akita11/SolenoidController/README.md

# SolenoidController

・ソレノイドやDCモータを4個、制御できるボード。単体でスイッチでON/OFFできる。
・各種マイコン(Arduino, micro:bit, RaspberryPi, IchigoJam, Grove)からも制御できる。
・電源は24Vまで（使用するソレノイドにあわせる）
- オプションで、USB Type-C PDからの給電もできる（検証は不十分）

# Author

Junichi Akita (@akita11, akita@ifdl.jp)
