akita11/SolenoidController/SoneloidController_,man.pdf

## SoneloidControllerの使い方

@akita11

## ボードの概要・定格

- 最大４個のソレノイドを、ボード上のスイッチ、
マイコンから制御できる
- 電源はACアダプタ、電池等（microUSBも可）
- 電源電圧の最大値＝24V

## 各部の名称・機能

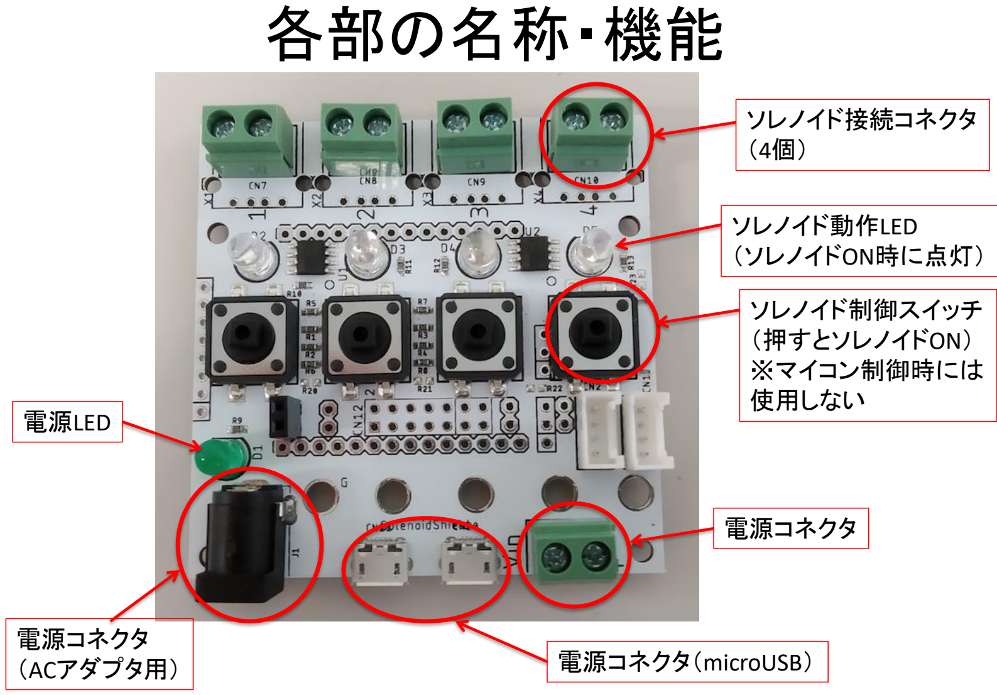
[picture p1: page 3]

ソレノイド接続コネクタ
（4個）

ソレノイド動作LED
（ソレノイドON時に点灯）

ソレノイド制御スイッチ
（押すとソレノイドON）
※マイコン制御時には
使用しない

電源コネクタ

電源コネクタ（microUSB）

電源LED

電源コネクタ
（ACアダプタ用）

## 電源の接続

- 以下のいずれかの電源を接続する
– ACアダプタ（φ2.1mm・センター＋）
– 電池ボックス等からの＋・ーのケーブル
– モバイルバッテリ等（microUSBケーブル経由） （原則として片方のコネクタのみ用いる）
- 電圧は用いるソレノイドにあわせる
- いずれか1つのみ接続する

### 緑色の端子に接続する場合の注意

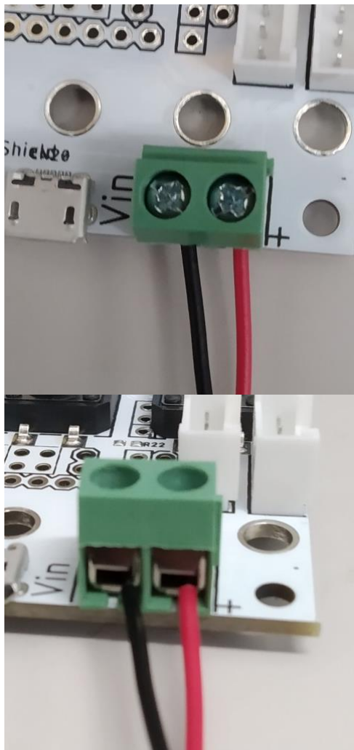
[picture p2: figure]

- ＋・－を間違えないように注意
する
※ソレノイド単体と異なり、逆接
続すると本ボードが故障します
- 端子からあまり導線の芯線が
出ないように注意（隣とショート
する危険がある）
- はずれやすい場合は棒端子を
用いるとよい

## 使用可能な電源の例

- 使用可能なACアダプタの例
– http://akizukidenshi.com/catalog/g/gM-06239/（12V・2A）
- 使用可能な電池ボックスの例

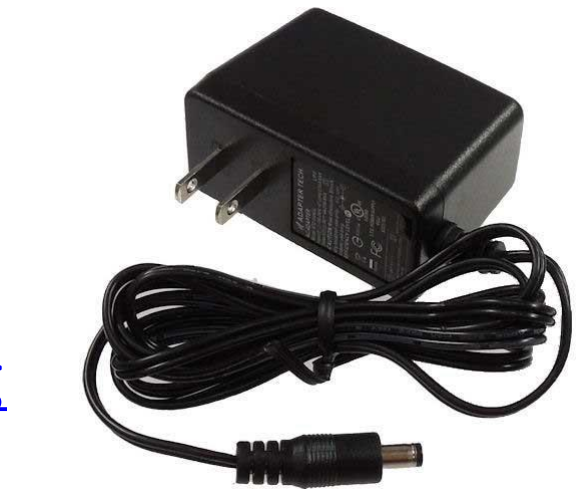
[picture p3: figure]

– http://akizukidenshi.com/catalog/g/gP-10612/

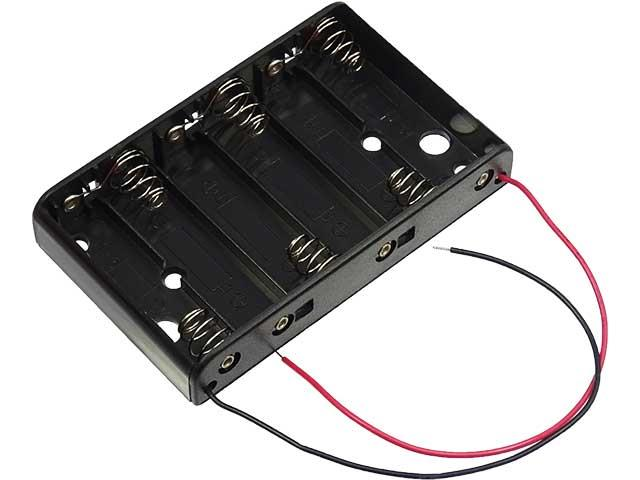
[picture p4: figure]

## ソレノイドの接続

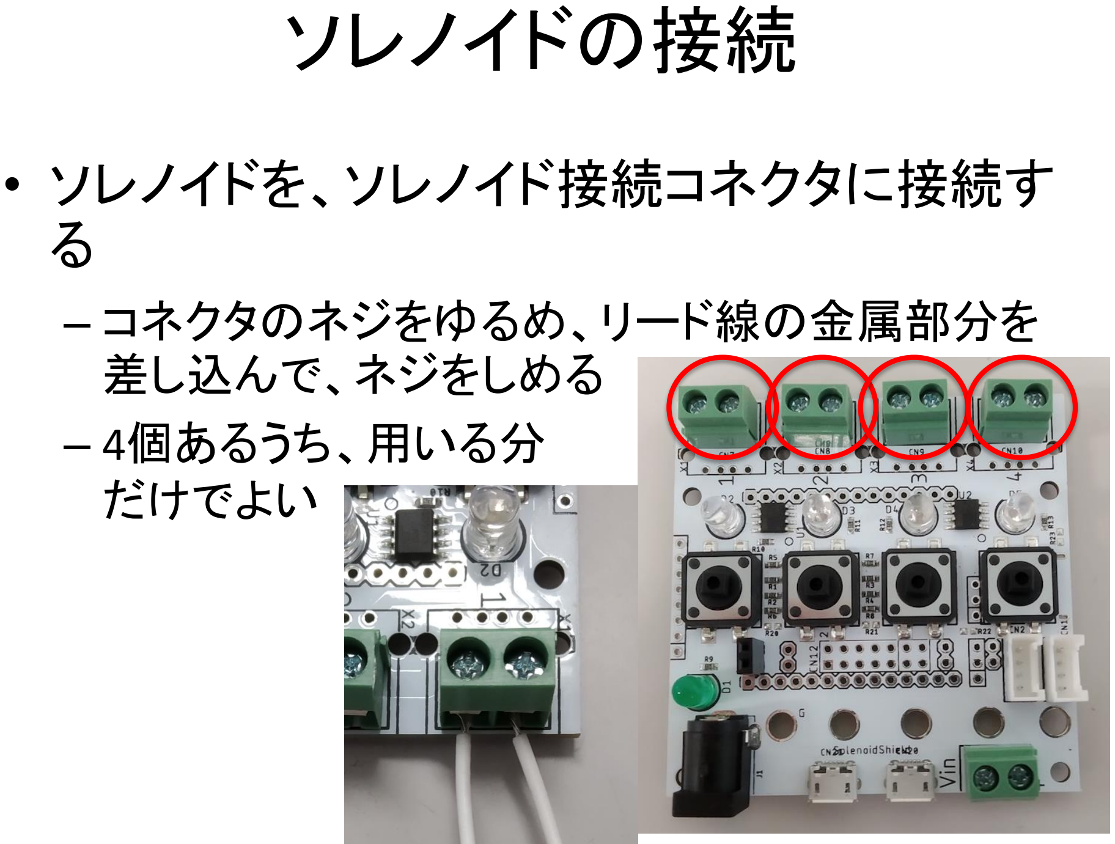
[picture p5: page 7]

- ソレノイドを、ソレノイド接続コネクタに接続す
る
– コネクタのネジをゆるめ、リード線の金属部分を
差し込んで、ネジをしめる
– 4個あるうち、用いる分
だけでよい

## 基本的な使い方

- 電源とソレノイドを接続後、スイッチを押すと、
対応するソレノイドがONになる

## Arduinoとの接続（１）

- ピンヘッダをとりつける（2p, 8p）

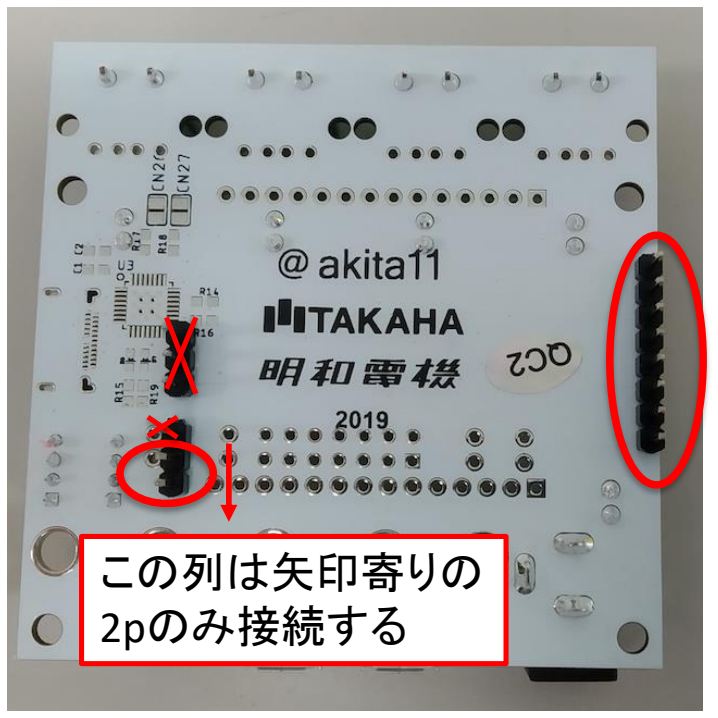
[picture p6: figure]
この列は矢印寄りの 2pのみ接続する

## Arduinoとの接続（２）

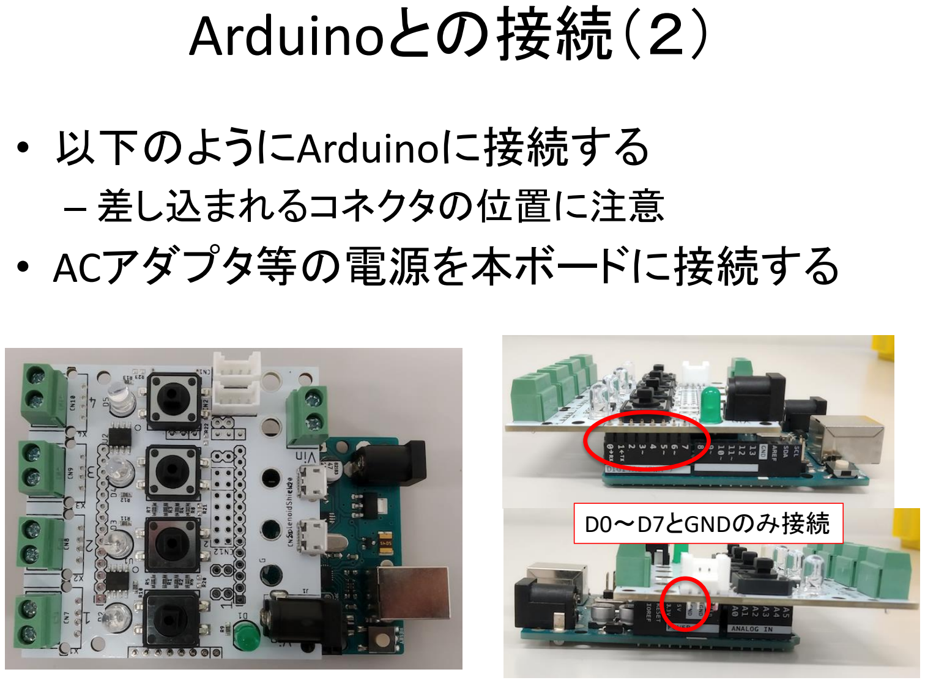
[picture p7: page 10]

- 以下のようにArduinoに接続する
– 差し込まれるコネクタの位置に注意
- ACアダプタ等の電源を本ボードに接続する

D0～D7とGNDのみ接続

## Arduinoとの接続（３）

- ArduinoのD2～D5が、ソレノイド#1～#4に対 応
- D2～D5をDigitalOutに設定
– 1(HIGH)=ON
– 0(LOW)=OFF

## micro:bitとの接続（１）

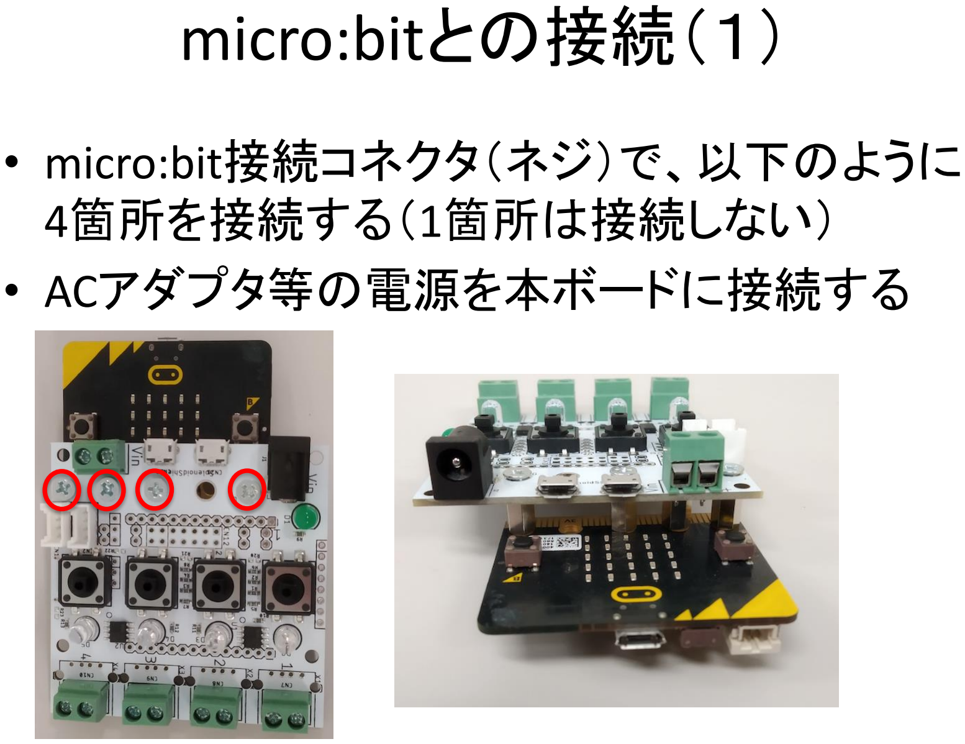
[picture p8: page 12]

- micro:bit接続コネクタ（ネジ）で、以下のように 4箇所を接続する（1箇所は接続しない）
- ACアダプタ等の電源を本ボードに接続する

## micro:bitとの接続（２）

- micro:bitのIOピンP0～2が、ソレノイド#1～#3 に対応
– ソレノイド#4は制御できない
- IOピン1～2を出力に設定
– 1(HIGH)=ON
– 0(LOW)=OFF

## Groveとの接続（１）

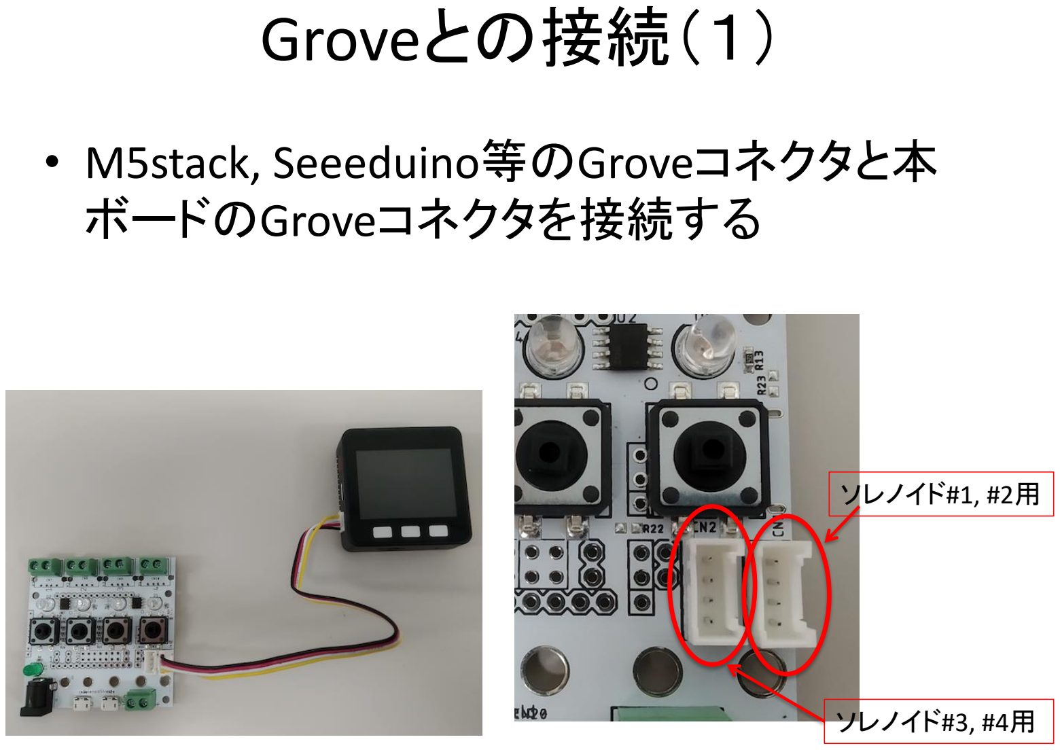
[picture p9: page 14]

- M5stack, Seeeduino等のGroveコネクタと本 ボードのGroveコネクタを接続する

ソレノイド#1, #2用

ソレノイド#3, #4用

## Groveとの接続（２）

- ソレノイド#1,#2用コネクタ
– GroveのディジタルIOの1番、2番に対応
– DigitalOutの1(HIGH)=On, 0(LOW)=Off
- ソレノイド#3,#4用コネクタ
– GroveのディジタルIOの1番、2番に対応
– DigitalOutの1(HIGH)=On, 0(LOW)=Off

## IchigoJamとの接続（１）

- ピンヘッダをとりつける（6p）

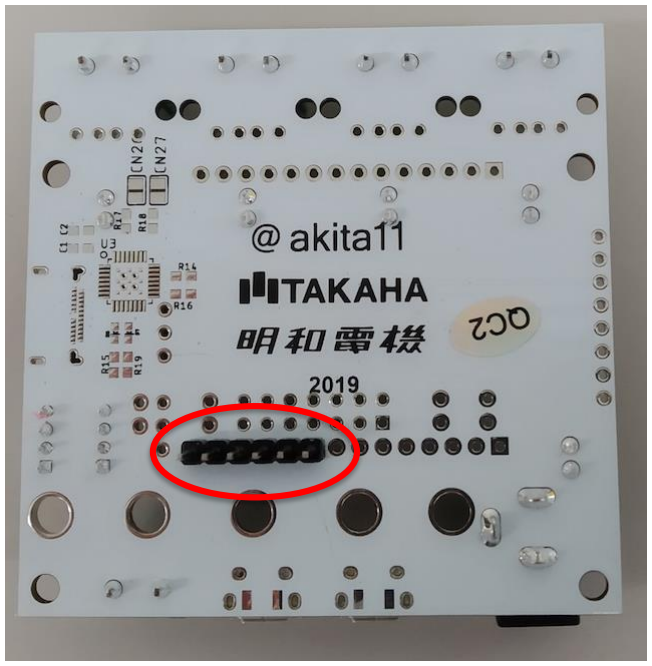
[picture p10: figure]

## IchigoJamとの接続（２）

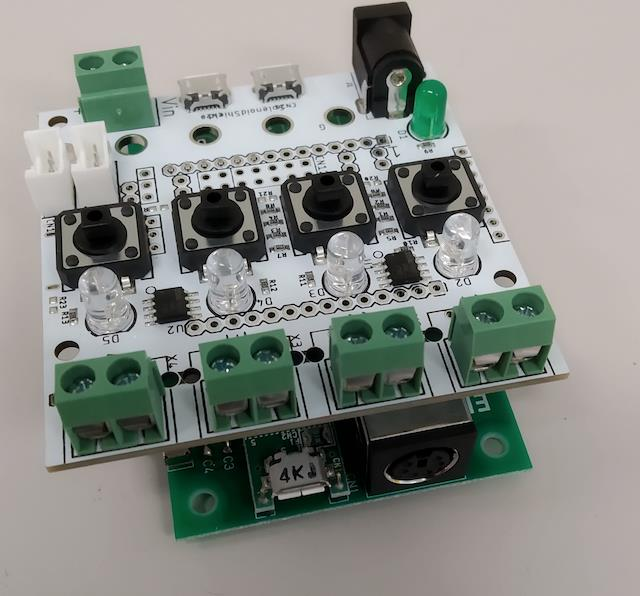
[picture p11: figure]
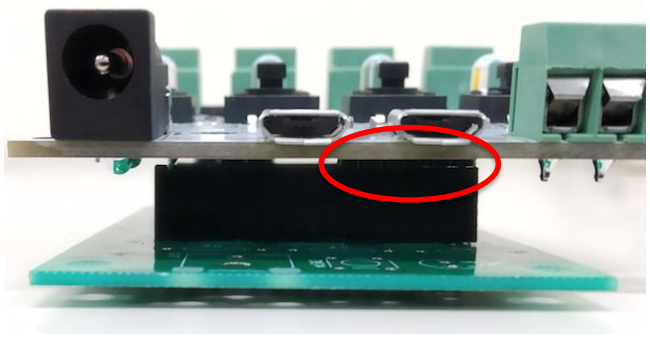
[picture p12: figure]

- 以下のようにIchigoJamに接続する
– 差し込まれるコネクタの位置に注意
- ACアダプタ等の電源を本ボードに接続する

## IchigoJamとの接続（３）

- IchigoJamのOUT1～4がソレノイド#1～#4に対 応
– 1(HIGH)=On
– 0(LOW)=Off

## RaspberryPiとの接続（１）

- ピンソケットをとりつける（2x7p）

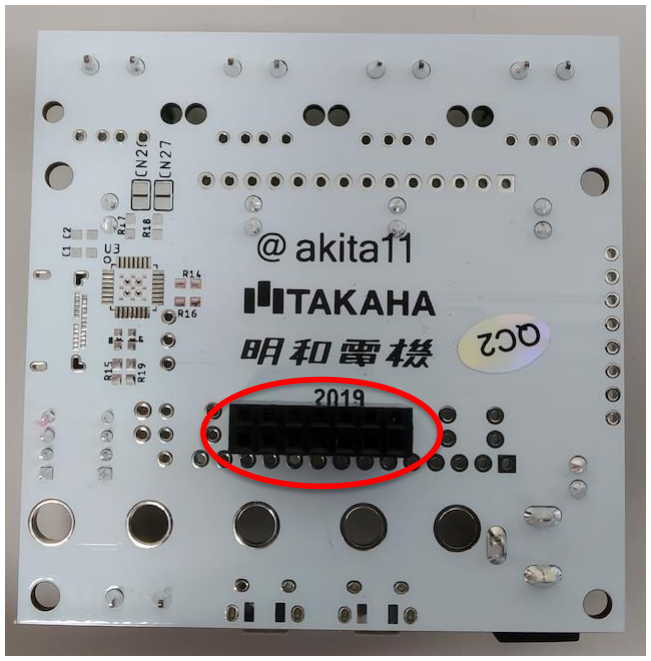
[picture p13: figure]

## RaspberryPiとの接続（２）

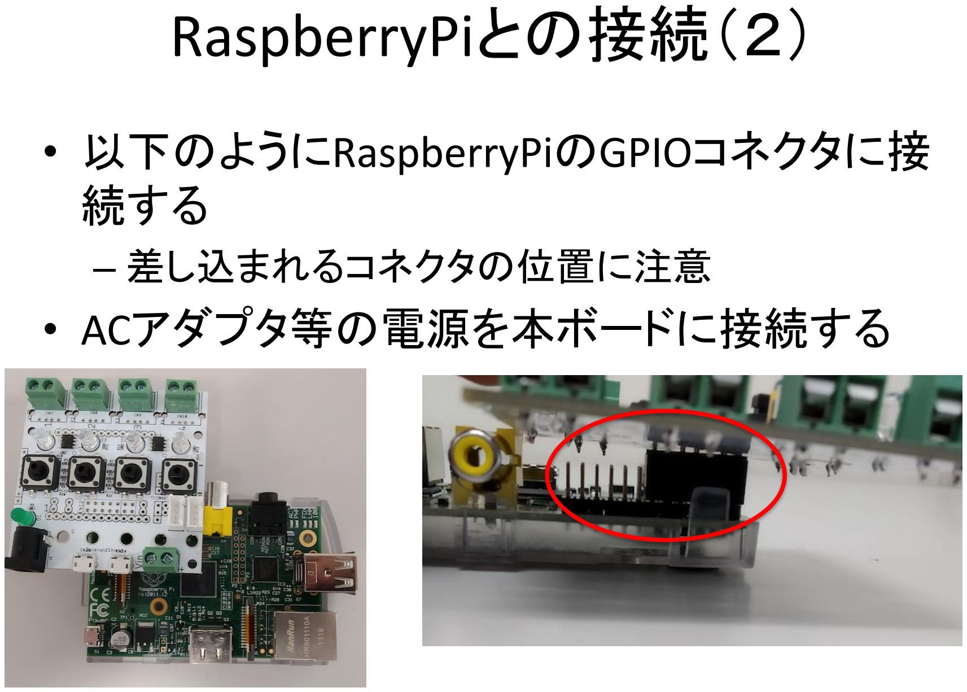
[picture p14: page 20]

- 以下のようにRaspberryPiのGPIOコネクタに接 続する
– 差し込まれるコネクタの位置に注意
- ACアダプタ等の電源を本ボードに接続する

## RaspberryPiとの接続（３）

- RaspberryPiのGPIO2,3,4,17がソレノイド#1～ #4に対応
– 1(HIGH)=On
– 0(LOW)=Off

## 外付けスイッチの接続

- 本ボード上の以下の端子（1組２ピン）にスイッ
チを接続する

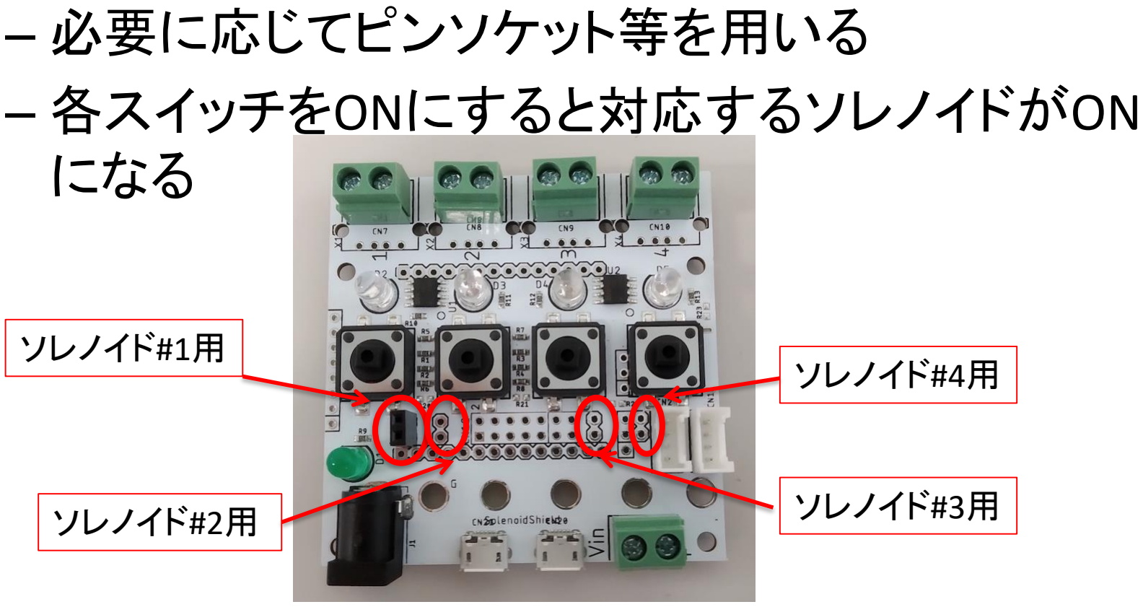
[picture p15: figure]
– 必要に応じてピンソケット等を用いる – 各スイッチをONにすると対応するソレノイドがON になる; ソレノイド#1用; ソレノイド#3用; ソレノイド#4用; ソレノイド#2用
