akita11/SolenoidController/SolenoidController_sch.pdf

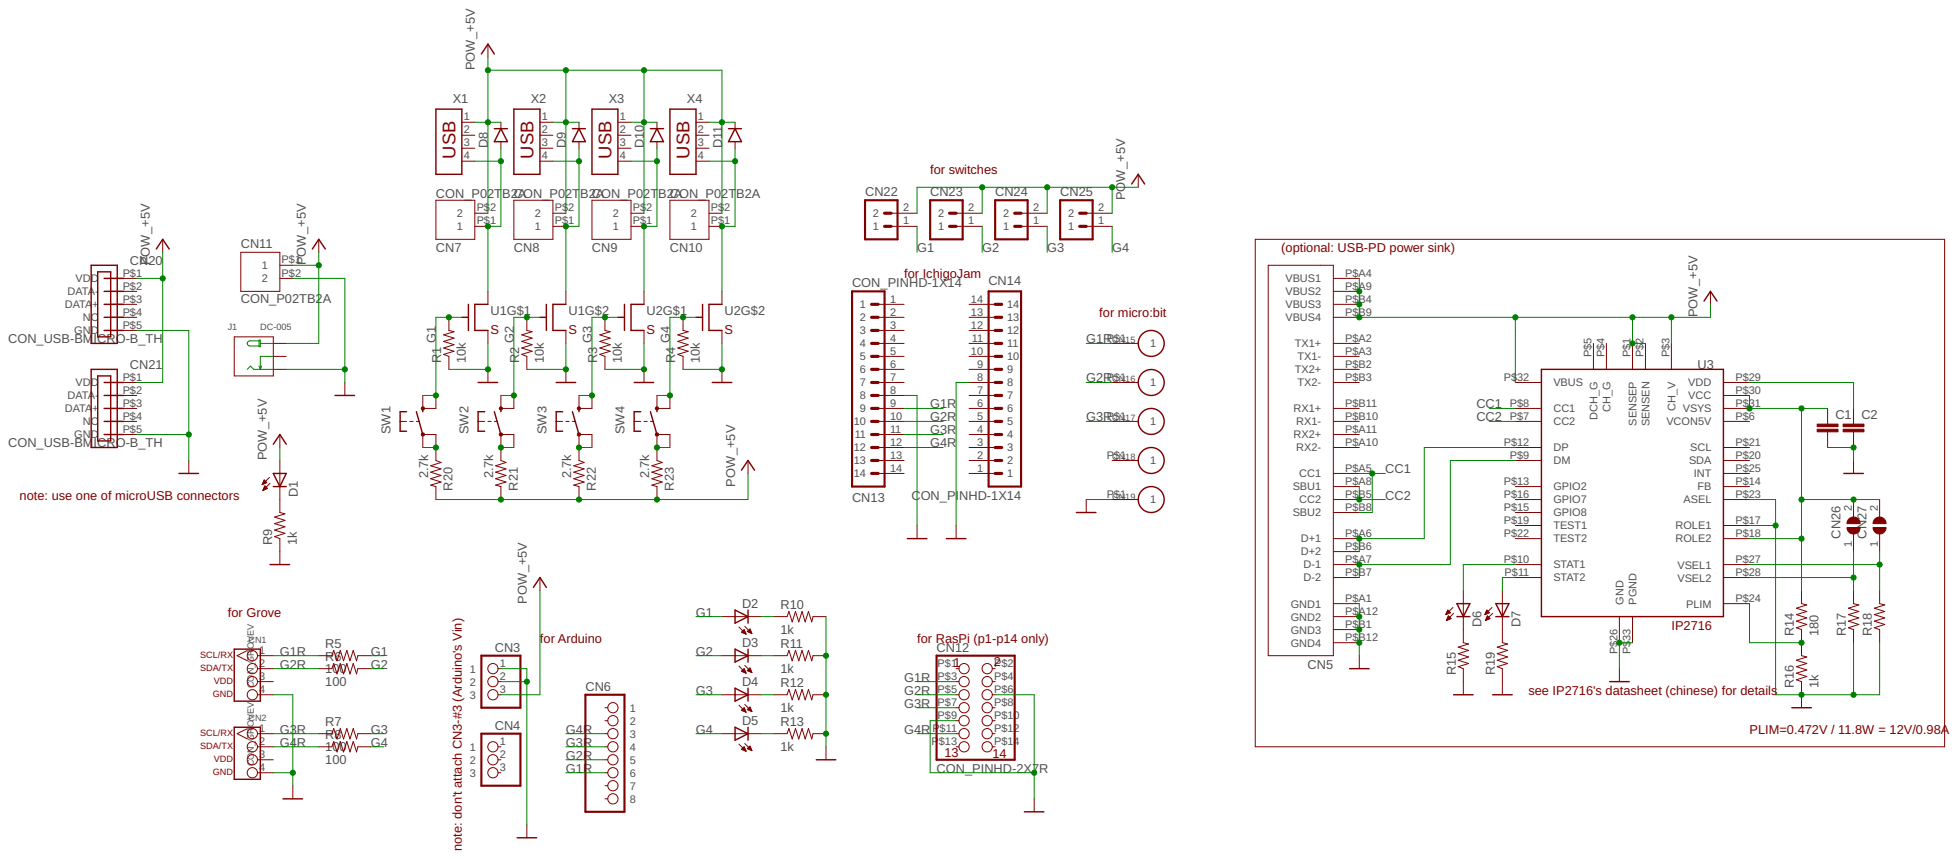
[picture p16: page 1]

USB USB

(optional: USB-PD power sink)

note: use one of microUSB connectors

see IP2716's datasheet (chinese) for details
