akita11/SolenoidController/SolenoidBoard_sch.pdf

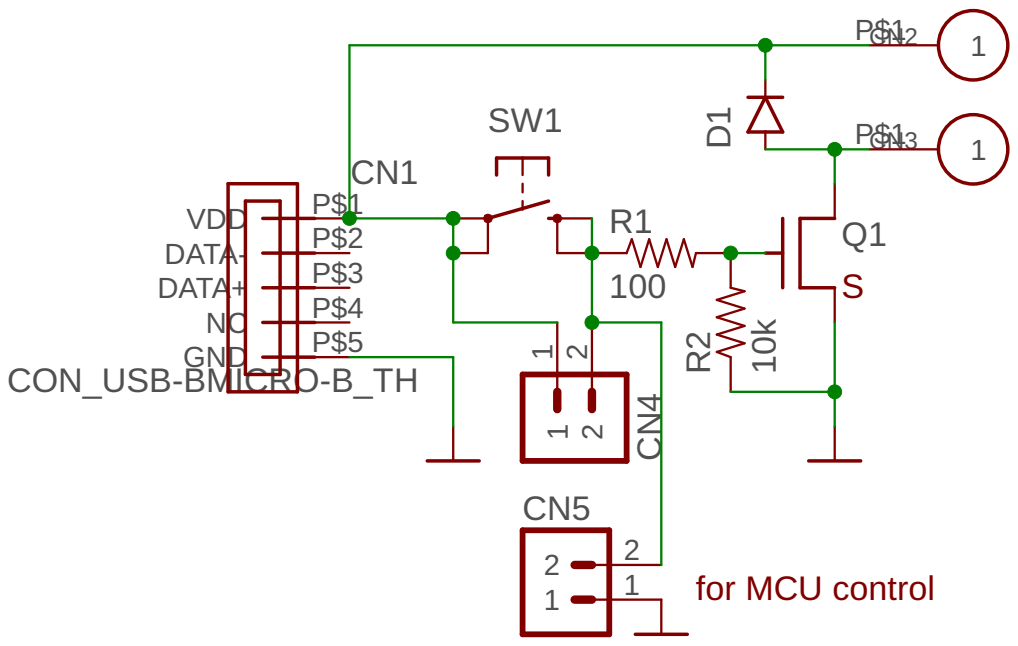
[picture p17: page 1]
