akita11/SolenoidController/SolenoidController.brd

## EAGLE design SolenoidController.brd (2019-08-27)

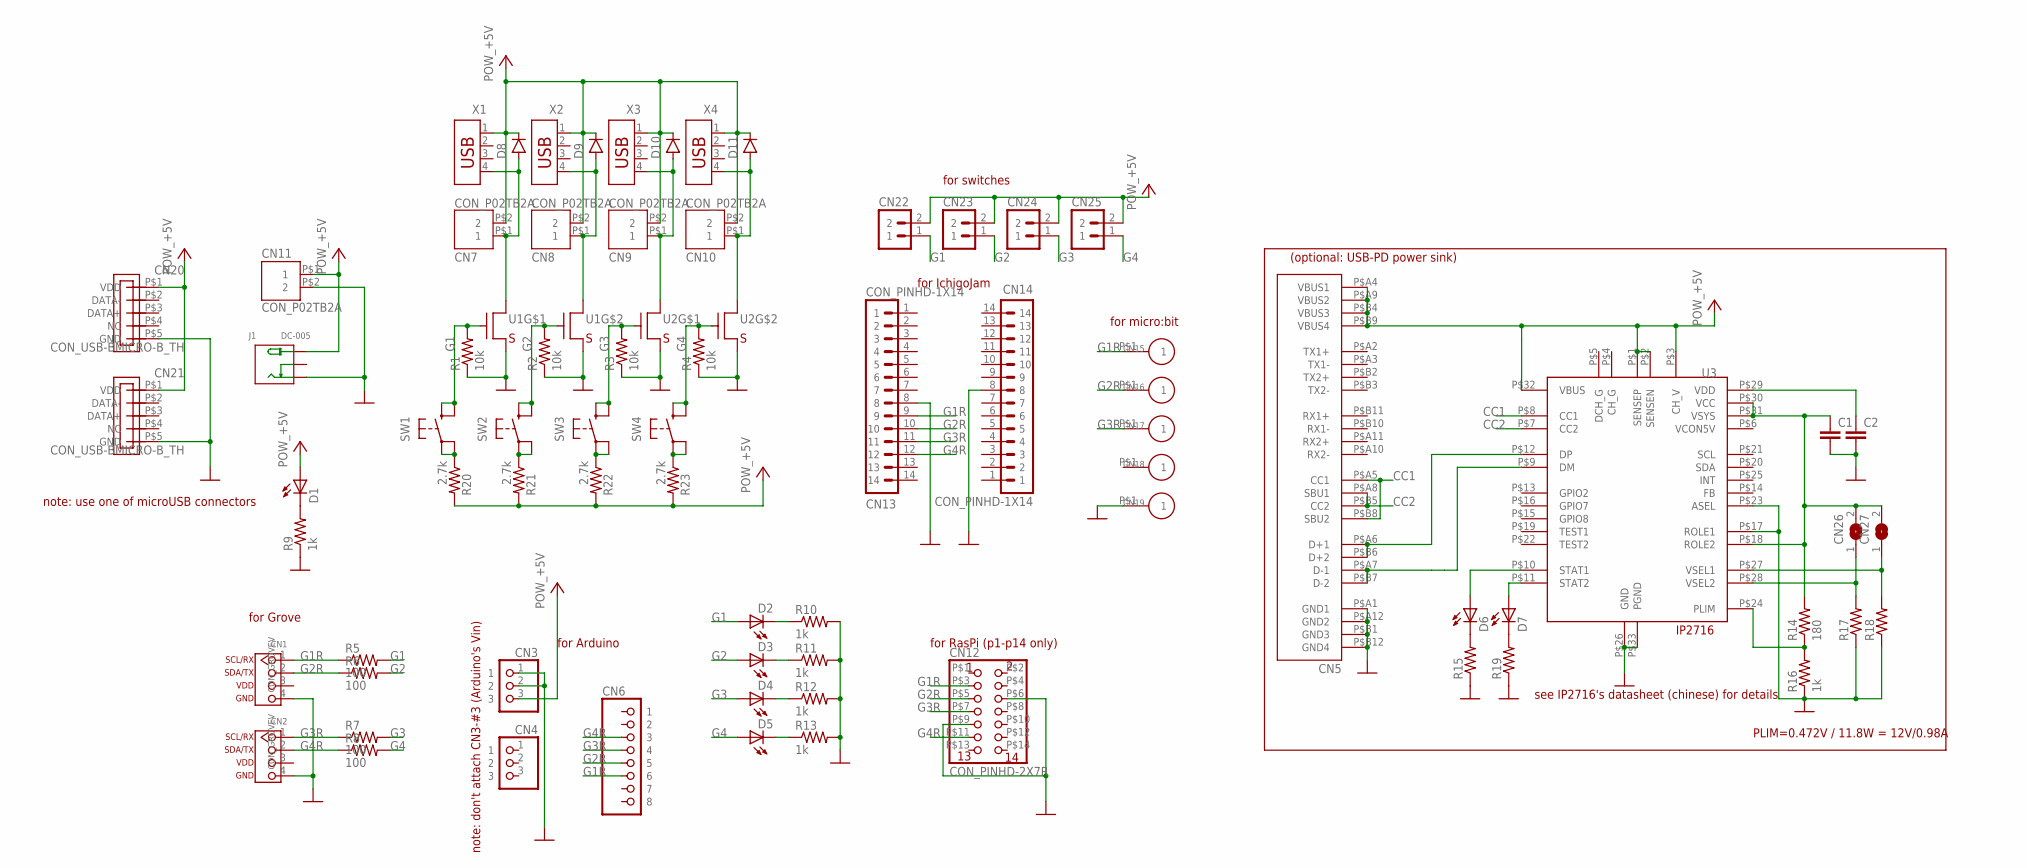
[picture p18: schematic SolenoidController.sch]

Parts:
C1, C2: CAP0603; 0603
CN1, CN2: CON_GROVEV; CON_GROVE_V
CN3, CN4: CON_PINHD-1X3R; 1X03R
CN5: CON_USB-C; USB-C_24P
CN6: CON_PINHD-1X8R; 1X08R
CN7, CN8, CN9, CN10, CN11: CON_P02TB2A; TERM_BLOCK_2P
CN12: CON_PINHD-2X7R; 2X7R
CN13, CN14: CON_PINHD-1X14; 1X14
CN15, CN16, CN17, CN18, CN19: CON_P01TH04MM; TH4MM
CN20, CN21: CON_USB-BMICRO-B_TH; USB-MICROB-TH
CN22, CN23, CN24, CN25: CON_PINHD-1X2PTH; SPARKFUN_1X02
CN26, CN27: JUMPER_SJ
D1, D2, D3, D4, D5: LED5MM; SPARKFUN_LED5MM
D6, D7: LED0603; SPARKFUN_LED-0603
D8, D9, D10, D11: DIODESOD123FL; SOD123FL
J1: DC-005; DCJ3P-14.2X11.0X9.0MM
R1, R2, R3, R4: 10k; 0603
R5, R6, R7, R8: 100; 0603
R9, R10, R11, R12, R13, R16: 1k; 0603
R14: 180; 0603
R15, R17, R18, R19: RES0603; 0603
R20, R21, R22, R23: 2.7k; 0603
SW1, SW2, SW3, SW4: SW_TACTSMD_B3FS4; SW_B3FS-4
U1, U2: TR_NMOS_IRF7103; SO08
U3: PMU_IP2716; QFN32E
X1, X2, X3, X4: CON_USB-A; USB-A

Connections:
+5V: CN3.3, CN5.P$A4 (VBUS1), CN5.P$A9 (VBUS2), CN5.P$B4 (VBUS3), CN5.P$B9 (VBUS4), CN7.P$2 (2), CN8.P$2 (2), CN9.P$2 (2), CN10.P$2 (2), CN11.P$1 (1), CN20.P$1 (VDD), CN21.P$1 (VDD), CN22.2, CN23.2, CN24.2, CN25.2, D1.A, D8.P$K, D9.P$K, D10.P$K, D11.P$K, J1.+, R20.2, R21.2, R22.2, R23.2, U3.P$1 (SENSEP), U3.P$2 (SENSEN), U3.P$3 (CH_V), U3.P$32 (VBUS), X1.1, X2.1, X3.1, X4.1
CC1: CN5.P$A5 (CC1), CN5.P$B8 (SBU2), U3.P$8 (CC1)
CC2: CN5.P$A8 (SBU1), CN5.P$B5 (CC2), U3.P$7 (CC2)
G1: CN22.1, D2.A, R1.2, R5.2, SW1.P$3 (S), SW1.P$4 (S1), U1.2 (G)
G1R: CN1.1, CN6.6, CN12.P$3 (3), CN13.9, CN15.P$1, R5.1
G2: CN23.1, D3.A, R2.2, R6.2, SW2.P$3 (S), SW2.P$4 (S1), U1.4 (G)
G2R: CN1.2, CN6.5, CN12.P$5 (5), CN13.10, CN16.P$1, R6.1
G3: CN24.1, D4.A, R3.2, R7.2, SW3.P$3 (S), SW3.P$4 (S1), U2.2 (G)
G3R: CN2.1, CN6.4, CN12.P$7 (7), CN13.11, CN17.P$1, R7.1
G4: CN25.1, D5.A, R4.2, R8.2, SW4.P$3 (S), SW4.P$4 (S1), U2.4 (G)
G4R: CN2.2, CN6.3, CN12.P$11 (11), CN13.12, R8.1
GND: C1.2, C2.2, CN1.4, CN2.4, CN3.1, CN3.2, CN5.P$A1 (GND1), CN5.P$A12 (GND2), CN5.P$B1 (GND3), CN5.P$B12 (GND4), CN11.P$2 (2), CN12.P$6 (6), CN12.P$9 (9), CN13.8, CN14.8, CN19.P$1, CN20.P$5 (GND), CN21.P$5 (GND), J1.-1 (-), R1.1, R2.1, R3.1, R4.1, R9.1, R10.2, R11.2, R12.2, R13.2, R15.1, R16.1, R17.1, R18.1, R19.1, U1.1 (S), U1.3 (S), U2.1 (S), U2.3 (S), U3.P$17 (ROLE1), U3.P$23 (ASEL), U3.P$26 (GND), U3.P$33 (PGND)
unnamed: CN7.P$1 (1), D8.P$A, U1.7 (D), X1.4
unnamed: CN8.P$1 (1), D9.P$A, U1.5 (D), X2.4
unnamed: CN9.P$1 (1), D10.P$A, U2.7 (D), X3.4
unnamed: C2.1, U3.P$29 (VDD)
unnamed: D1.K (C), R9.2
unnamed: D2.K (C), R10.1
unnamed: R14.1, R16.2, U3.P$24 (PLIM)
unnamed: D3.K (C), R11.1
unnamed: CN26.1, R17.2, U3.P$28 (VSEL2)
unnamed: D4.K (C), R12.1
unnamed: R21.1, SW2.P$1, SW2.P$2 (P1)
unnamed: D5.K (C), R13.1
unnamed: CN27.1, R18.2, U3.P$27 (VSEL1)
unnamed: C1.1, CN26.2, CN27.2, R14.2, U3.P$18 (ROLE2), U3.P$30 (VCC), U3.P$31 (VSYS)
unnamed: D6.C, R15.2
unnamed: CN10.P$1 (1), D11.P$A, U2.5 (D), X4.4
unnamed: D7.C, R19.2
unnamed: D7.A, U3.P$11 (STAT2)
unnamed: D6.A, U3.P$10 (STAT1)
unnamed: CN5.P$A6 (D+1), CN5.P$B6 (D+2), U3.P$12 (DP)
unnamed: R23.1, SW4.P$1, SW4.P$2 (P1)
unnamed: CN5.P$A7 (D-1), CN5.P$B7 (D-2), U3.P$9 (DM)
unnamed: R22.1, SW3.P$1, SW3.P$2 (P1)
unnamed: R20.1, SW1.P$1, SW1.P$2 (P1)

Notes on the sheet:
for RasPi (p1-p14 only)
PLIM=0.472V / 11.8W = 12V/0.98A
for switches
note: use one of microUSB connectors
for Grove
note: don't attach CN3-#3 (Arduino's Vin)
for Arduino
for micro:bit
for IchigoJam
IP2716
see IP2716's datasheet (chinese) for details
(optional: USB-PD power sink)

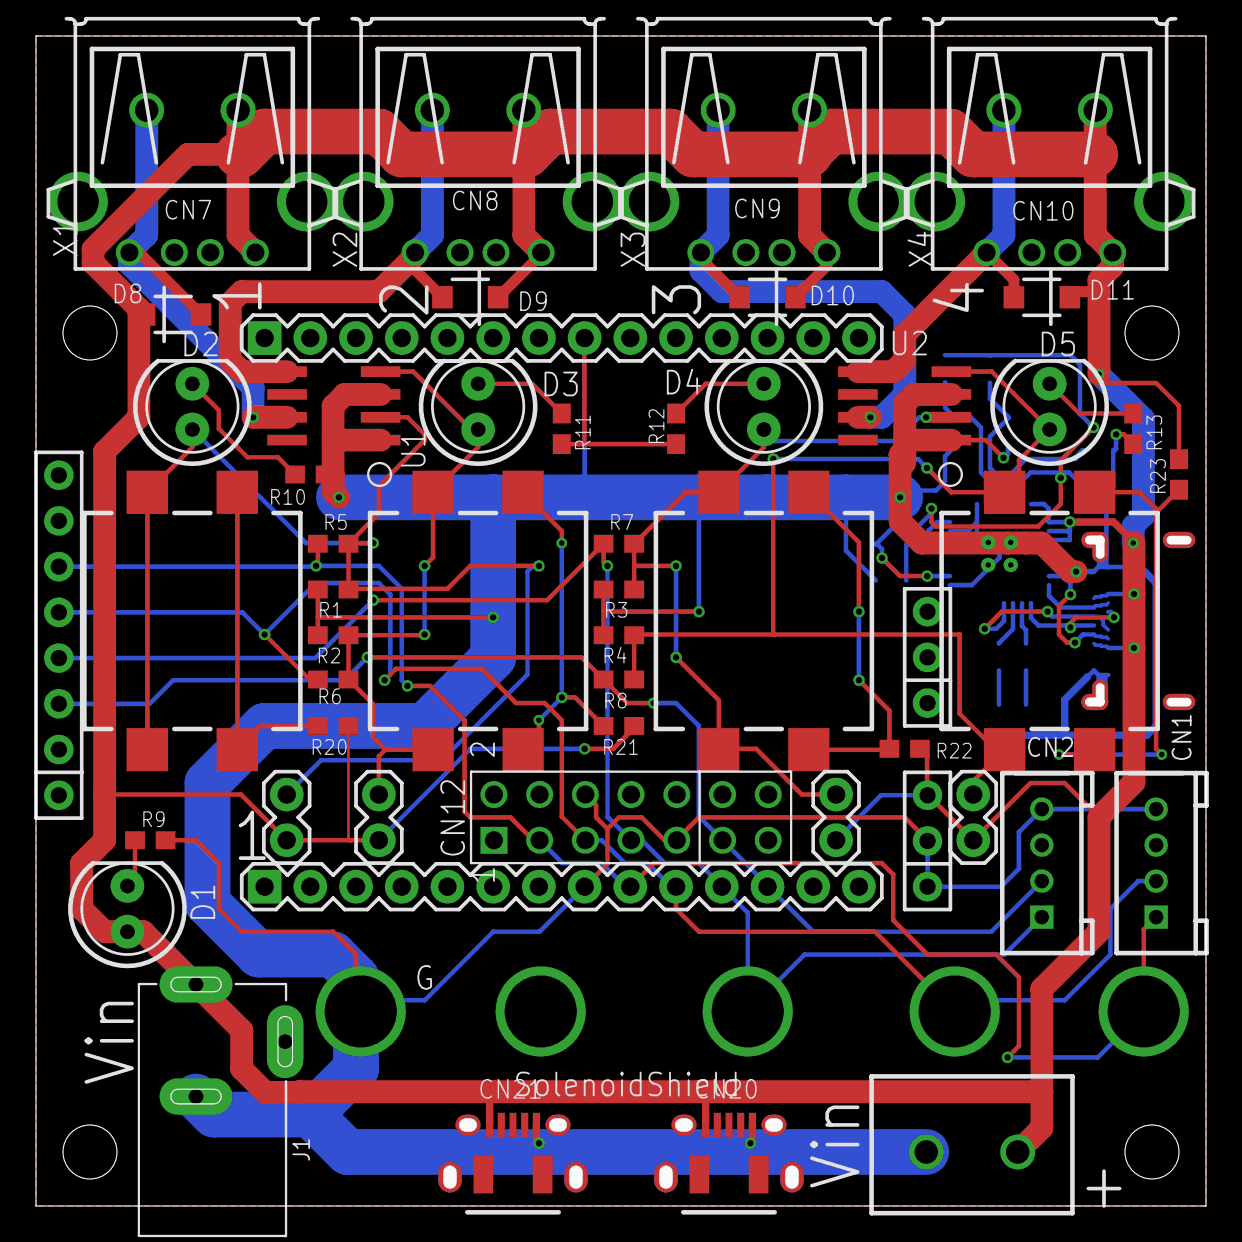
[picture p19: board SolenoidController.brd from above]

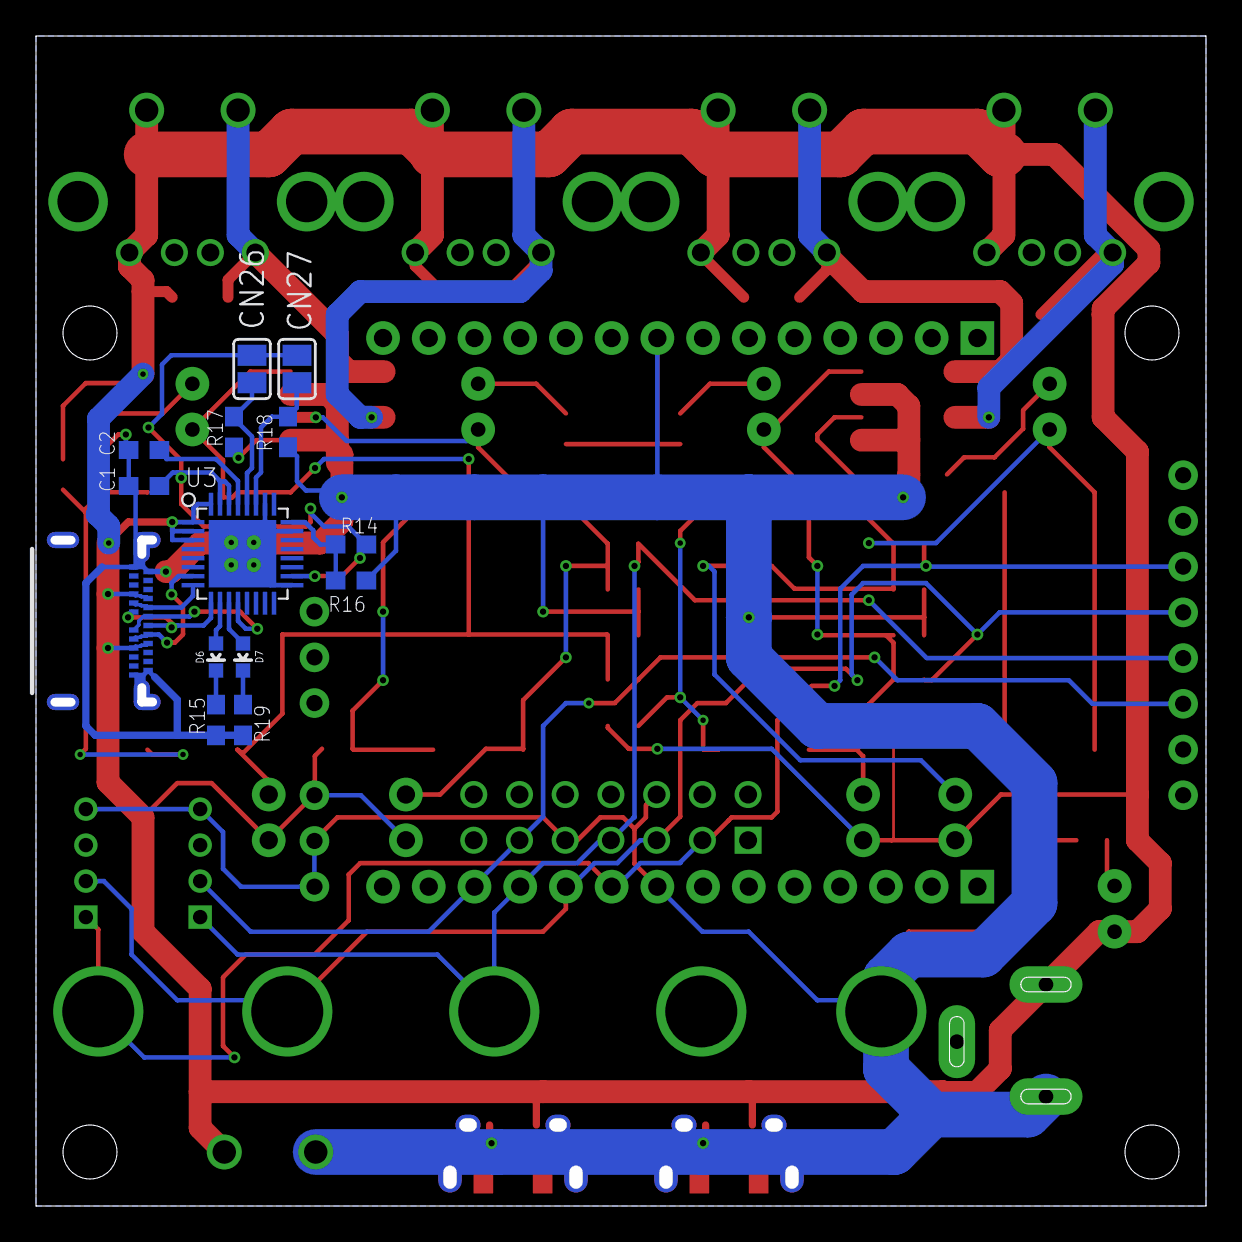
[picture p20: board SolenoidController.brd from below]

Board: 2 copper layers, 65.0 x 65.0 mm, 75 parts (14 on the bottom side), 36 nets.
