akita11/SolenoidController/SolenoidBoard.brd

## EAGLE design SolenoidBoard.brd (2019-08-27)

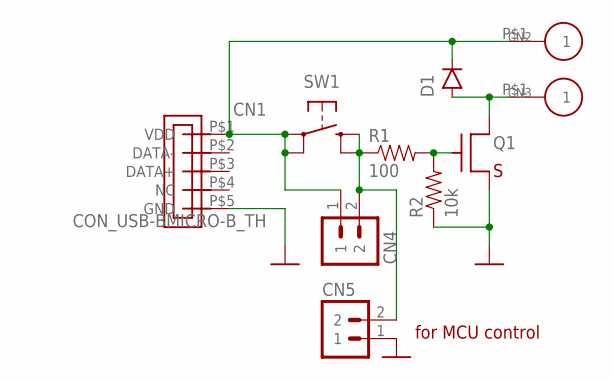
[picture p21: schematic SolenoidBoard.sch]

Parts:
CN1: CON_USB-BMICRO-B_TH; USB-MICROB-TH
CN2, CN3: CON_P01TH09MM; PAD_TH09MM
CN4: CON_PINHD-1X290; 1X02/90
CN5: CON_PINHD-1X2PTH; SPARKFUN_1X02
D1: DIODESOD123FL; SOD123FL
Q1: TR_NMOS_IRLML6344; SOT-23-3-2916
R1: 100; 0603
R2: 10k; 0603
SW1: SW_TACTSMD_B3FS; SW_B3FS-1

Connections:
GND: CN1.P$5 (GND), CN5.1, Q1.2 (S), R2.1
unnamed: CN3.P$1, D1.P$A, Q1.3 (D)
unnamed: CN1.P$1 (VDD), CN2.P$1, CN4.1, D1.P$K, SW1.P$1, SW1.P$2 (P1)
unnamed: Q1.1 (G), R1.2, R2.2
unnamed: CN4.2, CN5.2, R1.1, SW1.P$3 (S), SW1.P$4 (S1)

Notes on the sheet:
for MCU control

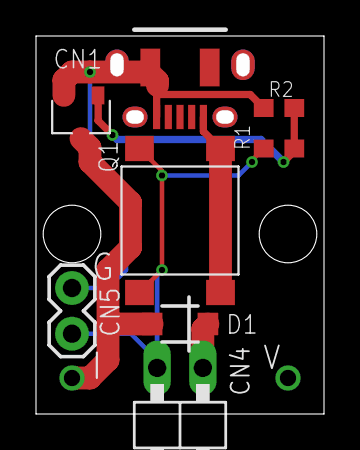
[picture p22: board SolenoidBoard.brd from above]

Board: 2 copper layers, 16.0 x 21.0 mm, 10 parts (0 on the bottom side), 5 nets.
