akita11/SolenoidController/(threads)

Thread 1 (2023-10-30):

ソレノイドの制御について

flow708613, 2023-10-30:
ACアダプタ用の電源コネクタから電源を繋いでいる状態です。この際3つ目のソレノイドしか制御スイッチで動作しないのですがこれは正常でしょうか？

akita11, 2023-10-30:
それは初めて聞く現象です。もう少し詳しい状況を教えていただけますか。（つなげているマイコンと接続方法、つないでいるソレノイド、マイコンのプログラムなど）

flow708613, 2023-10-31:
お返事ありがとうございます。

私のお伝えの仕方が悪く申し訳ありません。
お伺いしたいこととしましては
・電源のみを繋いだ状態で制御スイッチを押すとソレノイド動作LEDが3番目のもののみ反応するのですが, これは正常でしょうか
という点でした。この状態でマイコン（Rasberry pi）に接続して（pdfの通り）, 動作させようとしましたが3番目のもののみ反応する状況です。使用しているソレノイドはタカハのプッシュソレノイド([CB0730](https://www.takaha-shop.com/SHOP/cb0730.html))になります。以下使用したプログラムになります(Python)。
Pinをソレノイド#3に対応している4に設定した場合のみ動いている状況です。

`import RPi.GPIO as GPIO
import time

PIN = 2
GPIO.setmode(GPIO.BCM)
GPIO.setup(PIN, GPIO.OUT)

GPIO.output(PIN,1)
time.sleep(1.4)
GPIO.output(PIN,0)

GPIO.cleanup()`

akita11, 2023-10-31:
電源のみ接続（マイコンやソレノイドは接続していない）の状態で、
・3番のボタンを押す→3番のLED点灯
・それ以外のボタンを押す→対応するLEDが点灯しない
ということでしょうか。

あわせて、ソレノイド・マイコンをつないでの動作でも、3番以外は該当GPIO=1としても、LEDも点灯せずソレノイドもONにならない、ということでしょうか。

そうであれば、それは本来の動作ではないですね。購入した直後でこの現象でしょうか？それとも、使っているうちにこうなった、ということでしょうか。
前者であれば、不良品の可能性が高いので、購入元（タカハ？）へ問い合わせをお願い致します。

flow708613, 2023-10-31:
前者の通りです。了解いたしました。タカハの方まで問い合わせをいたします。
ご丁寧に対応いただきありがとうございました。
