akita11/SolenoidController/(commit log)

2019-08-27 各種データのinitial commit
    [SolenoidBoard.brd, SolenoidBoard.sch, SolenoidController.brd, SolenoidController.sch]
2019-08-27 brdの差し替え
    [SolenoidBoard.brd, SolenoidController.brd]
